BadgePiratesLLC/CactusCon13/BOM/CC13-MainBoard-BOM.csv

Reference | Qty | Value | Footprint | MPN | LCSC# | Manufacturer | DNP
BT1,BT2 | 2 | Battery | BadgePirates:Battery - 14500 | 53 |  | Keystone Electronics
BZ1 | 1 | Buzzer | BadgePirates:FUET-9032-Buzzer | FUET-9032 |  | Fuet Electronics
C2 | 1 | 1uF | BadgePirates:C_0805_2012Metric | CL21B105KBFNNNE | C28323 | Samsung Electro-Mechanics
C3,C5,C6,C8,C10 | 5 | 0.1uF | BadgePirates:C_0805_2012Metric | CT41G-0805-2X1-50V-0.1μF-K(N) | C126469 | TORCH
C4 | 1 | 22uF | BadgePirates:C_0805_2012Metric | CL21A226MAYNNNE | C602037 | Samsung Electro-Mechanics
C7 | 1 | 100uF | BadgePirates:100uf_CP_Pad1.50x2.35mm | TAJB107M006RNJ | C7195 | KYOCERA AVX
C9 | 1 | 10uF | BadgePirates:C_0805_2012Metric | CL21A106KPCLQNC | C962097 | Samsung Electro-Mechanics
D1 | 1 | PWR | BadgePirates:LED_1206 | NCD1206C1 | C84273 | Foshan NationStar Optoelectronics
D2 | 1 | Charging | BadgePirates:LED_1206 | NCD1206B1 | C130717 | Foshan NationStar Optoelectronics
D3-D8 | 6 | LED | BadgePirates:LED_Osram_Lx_P47F_D2mm_ReverseMount_Proper_Mask Only | AA3528SYCKT09 |  | KingBright
D9,D14,D15 | 3 | WS2812B | BadgePiratesFootprints:LED_WS2812B_PLCC4_5.0x5.0mm_P3.2mm | WS2812B-B/T | C2761795 | Worldsemi
D10-D13 | 4 | WS2812B | BadgePirates:LED_WS2812B_PLCC4_5.0x5.0mm_P3.2mm | WS2812B-B/T | C2761795 | Worldsemi
D19 | 1 | PESD2USB3UV-TR | BadgePirates:SOT-23 | PESD2USB3UV-TR | C7202955 | TECH PUBLIC
F1,F2 | 2 | Fuse | BadgePirates:R_1206_3216Metric | TLC-NSMD200 | C261957 | TLC Electronic
J2 | 1 | Micro_SD_Card | BadgePirates:TF_PUSH | TF PUSH | C393941 | SHOU HAN
J3 | 1 | ILI9341V | Connector_PinHeader_2.54mm:PinHeader_1x14_P2.54mm_Vertical |  |  |  | DNP
J8 | 1 | USB_C_Plug_USB2.0 | BadgePirates:USB_C_Receptical-Jing | 918-418K2023S40019 | C709035 | Jing Extension of the Electronic Co.
R1,R9,R10 | 3 | 1k | BadgePirates:R_1206_3216Metric | RC1206FR-071KL | C131398 | YAGEO
R2 | 1 | 2k | BadgePirates:R_1206_3216Metric | RC1206FR-072KL | C133543 | YAGEO
R3 | 1 | 330 | BadgePirates:R_1206_3216Metric | AC1206JR-07330KL | C229929 | YAGEO
R5 | 1 | 1M | BadgePirates:R_1206_3216Metric | RC1206FR-071ML | C108083 | YAGEO
R6 | 1 | 0 | BadgePirates:R_1206_3216Metric | 1206W4F0000T5E | C17888 | UNI-ROYAL(Uniroyal Elec)
R7,R8 | 2 | 5.1k | BadgePirates:R_1206_3216Metric | RC1206FR-075K1L | C163372 | YEGEO
R13 | 1 | 10K | BadgePirates:R_1206_3216Metric | RC1206FR-0710KL | C132649 | YAGEO
RN1,RN3 | 2 | 10k_Array | BadgePirates:R_Array_Convex_4x0603 | YC164-RR-0710KL | C110924 | YAGEO
RN2 | 1 | 1k_Array | BadgePirates:R_Array_Convex_4x0603 | YC164-JR-071KL | C93675 | YAGEO
SW1 | 1 | On/Off | BadgePirates:SW_SPDT_PCM12 | SSSS811101 | C109335 | ALPSALPINE
SW2 | 1 | Boot | BadgePirates:Switch_Tactile_SMD_B3U-1000P-BPVersion | B3U-1000P | C231329 | Omron Electronics
SW3 | 1 | Reset | BadgePirates:Switch_Tactile_SMD_B3U-1000P-BPVersion | B3U-1000P | C231329 | Omron Electronics
SW4 | 1 | SW_Enter | BadgePirates:SW_SPST_TL3305C(small)
SW5 | 1 | SW_Back | BadgePirates:SW_SPST_TL3305C(small)
SW6 | 1 | RotaryEncoder_Switch | BadgePirates:SIQ-02FVS3_Encoder
U1 | 1 | LTC4054 | BadgePirates:LTC4054 | TP4054ST25K | TP4054ST25K | TPOWER
U2 | 1 | ESP32-S3-WROOM-1 N16 | BadgePirates:ESP32-S3-WROOM-1 | ESP32-S3-WROOM-1-N8R8 | C2913200 | ESPRESSIF
U3 | 1 | CH340N | BadgePirates:SOIC-8-1EP_W3.9mm | CH340N | C2977777 | WCH(Jiangsu Qin Heng)
U4 | 1 | TLV1117LV33 | BadgePirates:SOT-223 | TLV1117LV33DCYR | C15578 | Texas Instruments
U5 | 1 | MAX17048 | BadgePirates:MAX17048_TDFN | MAX17048G+ | C2682616 | Analog Devices Inc
