BadgePiratesLLC/CactusCon13/3d_Prints/STLs/Full Plate of ScreenBezel_x10.3mf

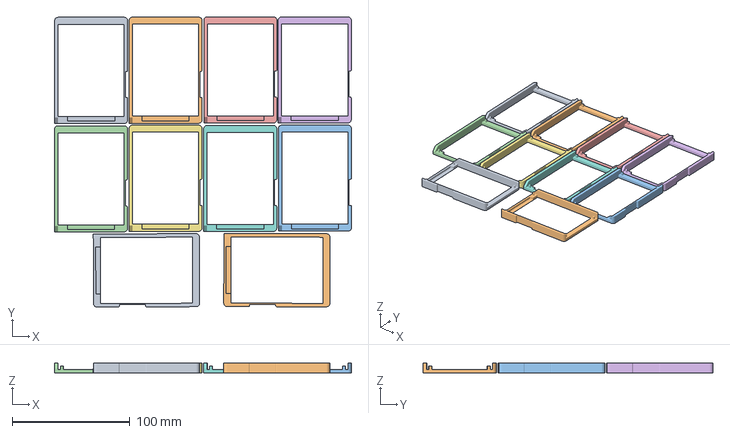
[picture p1: CAD file, 2025-03-16]
3d_Prints/STLs/Full Plate of ScreenBezel_x10.3mf
251.8 x 246.1 x 8.75 mm
ScreenProtector.stl x 10
