BadgePiratesLLC/CactusCon13/3d_Prints/STLs/Full Plate of BadgeStand-x18.3mf

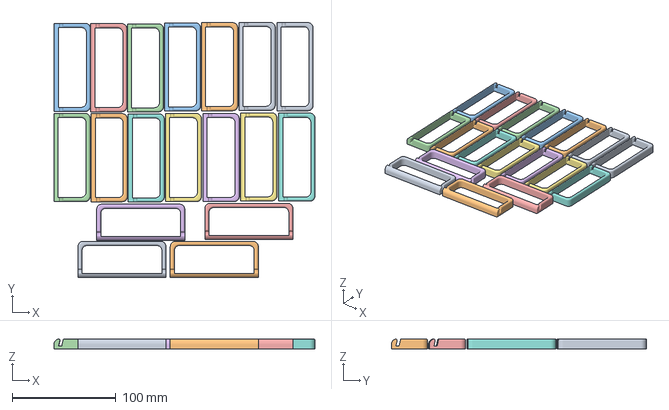
[picture p2: CAD file, 2025-03-16]
3d_Prints/STLs/Full Plate of BadgeStand-x18.3mf
251.8 x 246.4 x 10.0 mm
BadgeStand-v3.stl x 18
