BadgePiratesLLC/CactusCon13/3d_Prints/Models/BadgeStand v6.3mf

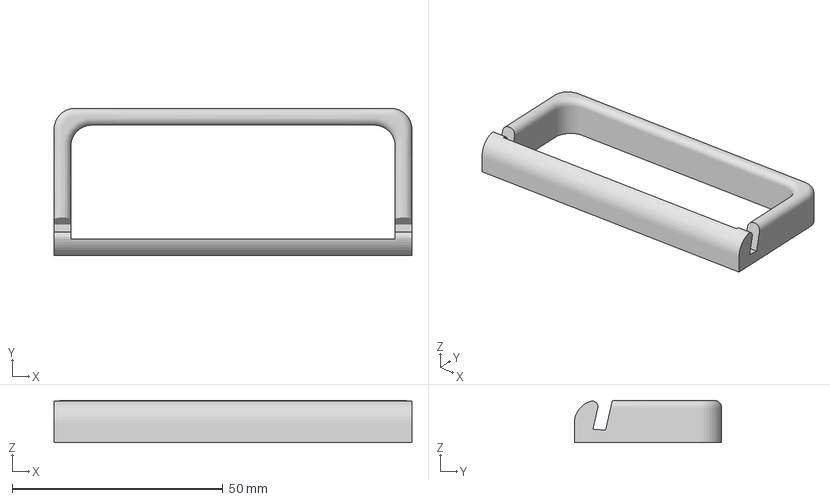
[picture p3: CAD file, 2025-03-16]
3d_Prints/Models/BadgeStand v6.3mf
85.0 x 35.0 x 10.0 mm
