BadgePiratesLLC/CactusCon13/CAD/Project-CC13.step

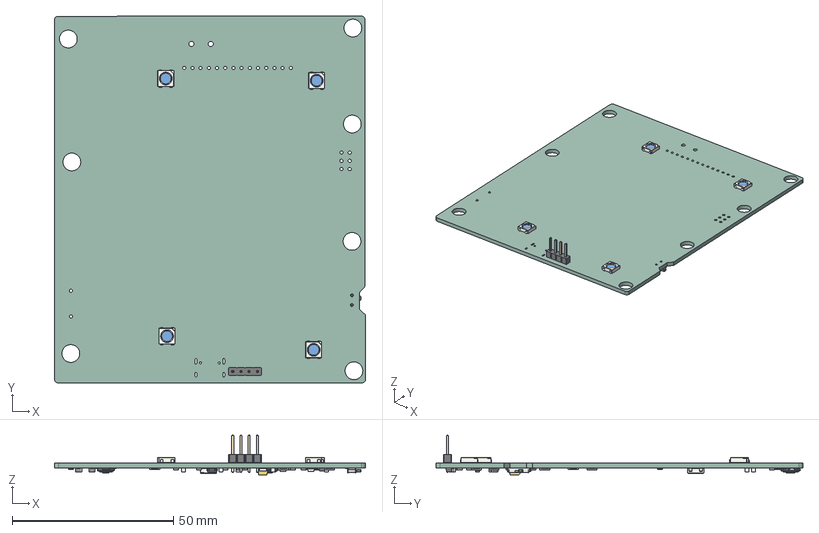
[picture p4: CAD file, 2025-03-16]
CAD/Project-CC13.step
96.5 x 113.7 x 12.3 mm
LED_WS2812B_PLCC4_50x50mm_P32mm x 5
PinHeader_1x04_P254mm_Vertical
LED_1206_3216Metric x 2
R_1206_3216Metric x 12
R_Array_Convex_4x0603 x 3
SOT_23
C_0805_2012Metric x 8
SW_SPST_TL3342 x 2
CP_EIA_3528_21_Kemet_B
Fusion_sp
DFN-8-1EP_2x2mm_Pitch0.5mm
Project-RTV_PCB
