BadgePiratesLLC/CactusCon13/3d_Prints/Models/ScreenBezel v5.3mf

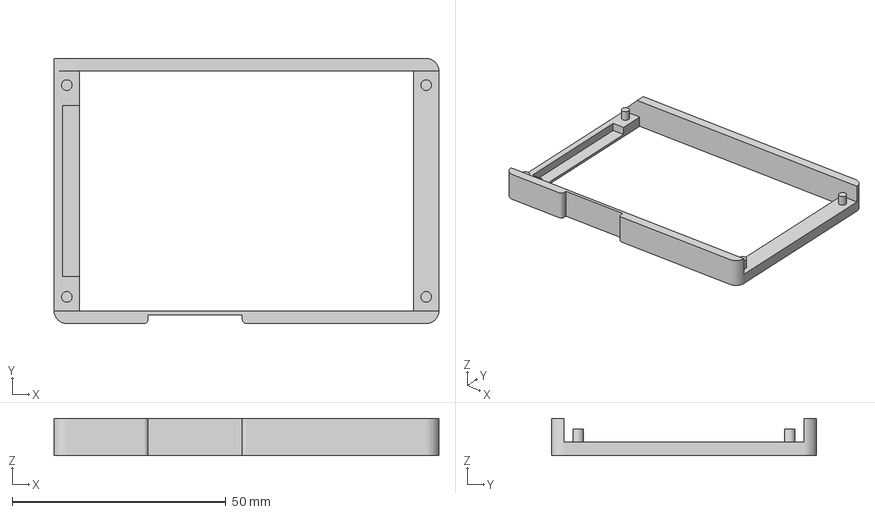
[picture p5: CAD file, 2025-03-16]
3d_Prints/Models/ScreenBezel v5.3mf
90.0 x 62.0 x 8.75 mm
