BadgePiratesLLC/CactusCon13/3d_Prints/STLs/Project-CC_SolderJig_All_x2.3mf

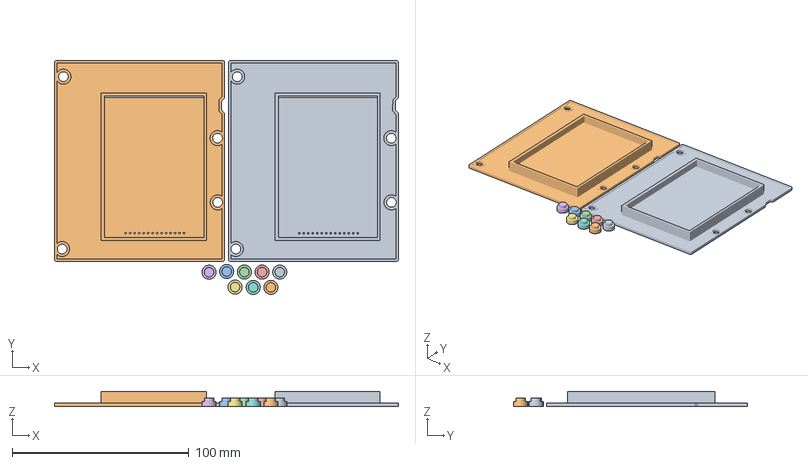
[picture p6: CAD file, 2025-03-16]
3d_Prints/STLs/Project-CC_SolderJig_All_x2.3mf
194.5 x 132.3 x 8.76 mm
Project-CC_SolderJigBody.stl x 2
Project-CC_SolderJig_Risers.stl x 8
