BadgePiratesLLC/CactusCon13/3d_Prints/STLs/Project-CC_SolderJigBody.stl

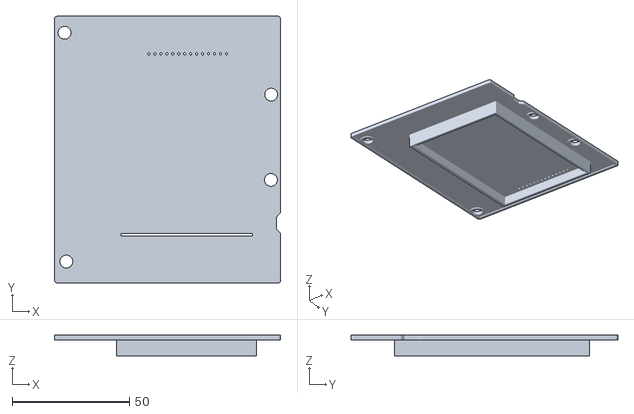
[picture p7: CAD file, 2025-03-16]
3d_Prints/STLs/Project-CC_SolderJigBody.stl
96.2 x 113.7 x 8.76
