BadgePiratesLLC/CactusCon13/3d_Prints/STLs/Project-CC_SolderJig_Risers.3mf

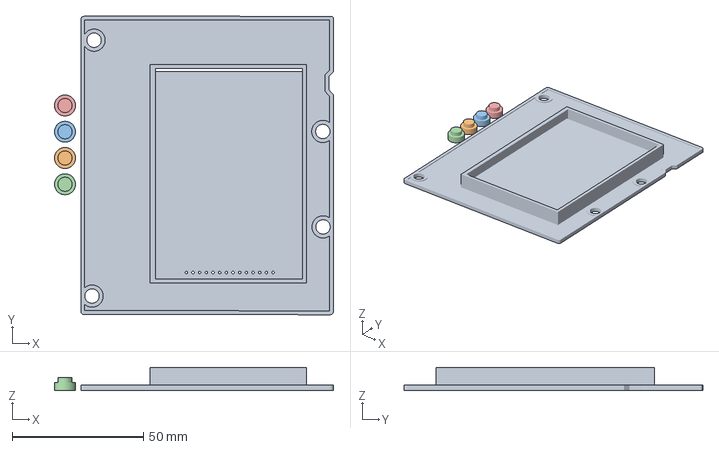
[picture p8: CAD file, 2025-03-16]
3d_Prints/STLs/Project-CC_SolderJig_Risers.3mf
106.2 x 113.7 x 8.76 mm
Project-CC_SolderJigBody.stl
Project-CC_SolderJig_Risers.stl x 4
