BadgePiratesLLC/CactusCon13/(list of files, cad)

Other CAD files:
3d_Prints/STLs/BadgeStand-v3.stl
3d_Prints/STLs/ScreenBezel-v3.stl
3d_Prints/Models/BadgeStand v6.f3d
3d_Prints/Models/ScreenBezel v5.f3d
3d_Prints/STLs/Project-CC_SolderJig&Risers.stl
