BadgePiratesLLC/CactusCon13/CAD/Project-CC13.kicad_pcb

## KiCad design CAD/Project-CC13.kicad_pcb (2025-03-16)

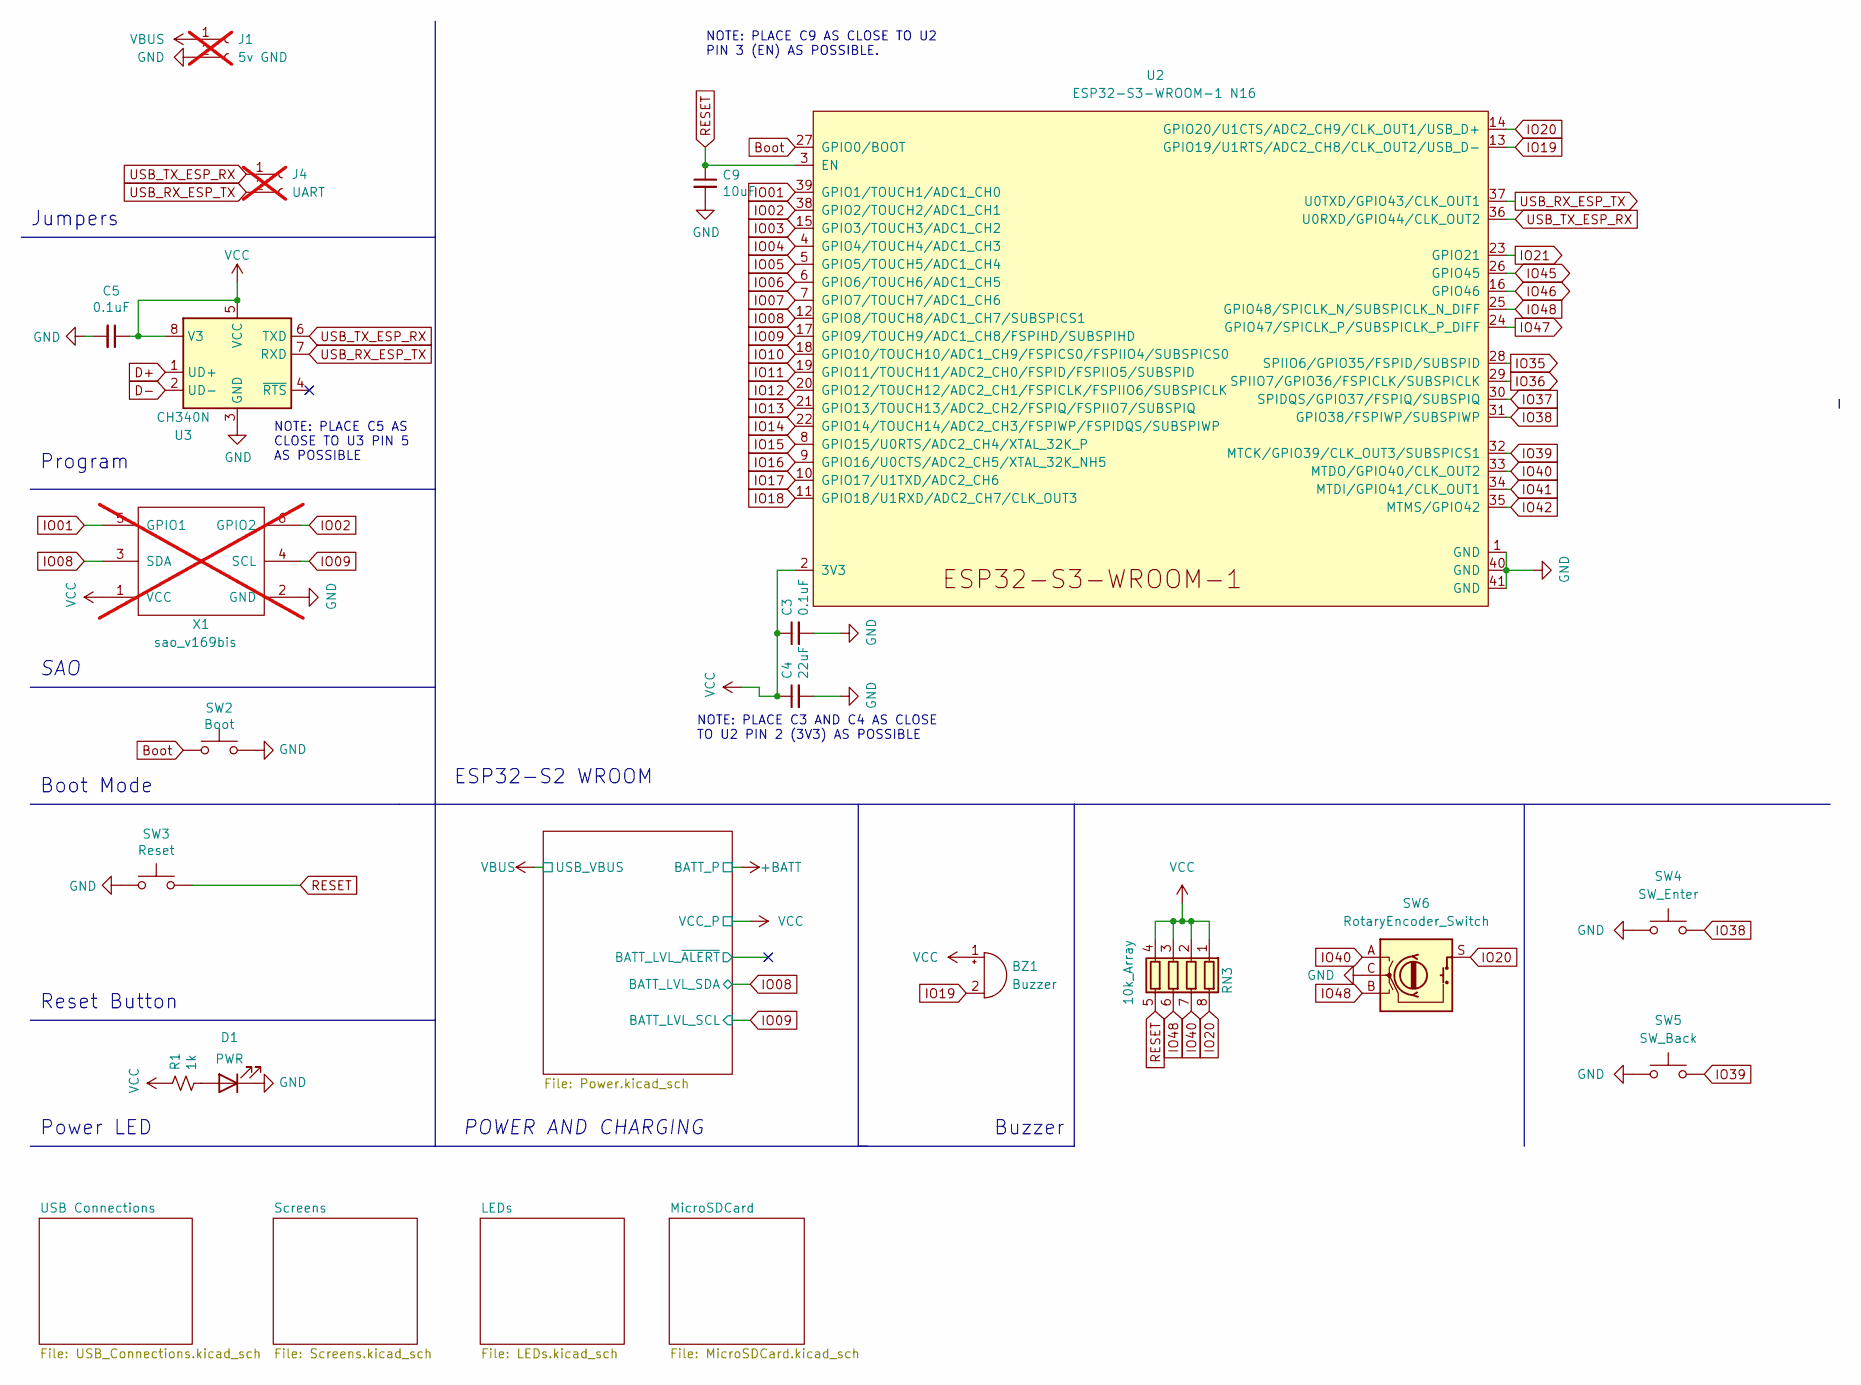
[picture p9: schematic Project-CC13.kicad_sch, CactusCon]

Parts:
BZ1: Buzzer; FUET-9032-Buzzer
C3, C5: 0.1uF; C_0805_2012Metric; MFG_PN CT41G-0805-2X1-50V-0.1μF-K(N)
C4: 22uF; C_0805_2012Metric; MFG_PN CL21A226MAYNNNE
C9: 10uF; C_0805_2012Metric; MFG_PN CL21A106KPCLQNC
D1: PWR; LED_1206; MFG_PN NCD1206C1
J1: 5v GND; PinHeader_1x02_P2.54mm_Vertical; not fitted
J4: UART; PinHeader_1x02_P2.54mm_Vertical; not fitted
R1: 1k; R_1206_3216Metric; MFG_PN RC1206FR-071KL
RN3: 10k_Array; R_Array_Convex_4x0603; MFG_PN YC164-RR-0710KL
SW2: Boot; Switch_Tactile_SMD_B3U-1000P-BPVersion; MFG_PN B3U-1000P
SW3: Reset; Switch_Tactile_SMD_B3U-1000P-BPVersion; MFG_PN B3U-1000P
SW4: SW_Enter; SW_SPST_TL3305C(small)
SW5: SW_Back; SW_SPST_TL3305C(small)
SW6: RotaryEncoder_Switch; SIQ-02FVS3_Encoder
U2: ESP32-S3-WROOM-1 N16; ESP32-S3-WROOM-1; MFG_PN ESP32-S3-WROOM-1-N8R8
U3: CH340N; SOIC-8-1EP_W3.9mm; MFG_PN CH340N
X1: sao_v169bis; Badgelife-SAOv169-SAO_Side_B.SLK; not fitted

Connections:
Boot: SW2.1, U2.27 (GPIO0/BOOT)
D+: U3.1 (UD+); also elsewhere on the board
D-: U3.2 (UD-); also elsewhere on the board
GND: C3.2, C4.2, C5.2, C9.2, D1.1 (K), J1.2, SW2.2, SW3.1, SW4.1, SW5.1, SW6.C, U2.1 (GND), U2.40 (GND), U2.41 (GND), U3.3 (GND), X1.2 (GND); also elsewhere on the board
IO01: U2.39 (GPIO1/TOUCH1/ADC1_CH0), X1.5 (GPIO1)
IO02: U2.38 (GPIO2/TOUCH2/ADC1_CH1), X1.6 (GPIO2)
IO03: U2.15 (GPIO3/TOUCH3/ADC1_CH2); also elsewhere on the board
IO04: U2.4 (GPIO4/TOUCH4/ADC1_CH3); also elsewhere on the board
IO05: U2.5 (GPIO5/TOUCH5/ADC1_CH4); also elsewhere on the board
IO06: U2.6 (GPIO6/TOUCH6/ADC1_CH5); also elsewhere on the board
IO07: U2.7 (GPIO7/TOUCH7/ADC1_CH6); also elsewhere on the board
IO08: U2.12 (GPIO8/TOUCH8/ADC1_CH7/SUBSPICS1), X1.3 (SDA); also elsewhere on the board
IO09: U2.17 (GPIO9/TOUCH9/ADC1_CH8/FSPIHD/SUBSPIHD), X1.4 (SCL); also elsewhere on the board
IO10: U2.18 (GPIO10/TOUCH10/ADC1_CH9/FSPICS0/FSPIIO4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); also elsewhere on the board
IO11: U2.19 (GPIO11/TOUCH11/ADC2_CH0/FSPID/FSPIIO5/S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); also elsewhere on the board
IO12: U2.20 (GPIO12/TOUCH12/ADC2_CH1/FSPICLK/FSPIIO6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); also elsewhere on the board
IO13: U2.21 (GPIO13/TOUCH13/ADC2_CH2/FSPIQ/FSPIIO7/S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); also elsewhere on the board
IO14: U2.22 (GPIO14/TOUCH14/ADC2_CH3/FSPIWP/FSPIDQS/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); also elsewhere on the board
IO15: U2.8 (GPIO15/U0RTS/ADC2_CH4/XTAL_32K_P); also elsewhere on the board
IO16: U2.9 (GPIO16/U0CTS/ADC2_CH5/XTAL_32K_NH5); also elsewhere on the board
IO17: U2.10 (GPIO17/U1TXD/ADC2_CH6); also elsewhere on the board
IO18: U2.11 (GPIO18/U1RXD/ADC2_CH7/CLK_OUT3); also elsewhere on the board
IO19: BZ1.2 (+), U2.13 (GPIO19/U1RTS/ADC2_CH8/CLK_OUT2/USB_D-)
IO20: RN3.8 (R1.2), SW6.S, U2.14 (GPIO20/U1CTS/ADC2_CH9/CLK_OUT1/USB_D+); also elsewhere on the board
IO21: U2.23 (GPIO21); also elsewhere on the board
IO35: U2.28 (SPIIO6/GPIO35/FSPID/SUBSPID); also elsewhere on the board
IO36: U2.29 (SPIIO7/GPIO36/FSPICLK/SUBSPICLK); also elsewhere on the board
IO37: U2.30 (SPIDQS/GPIO37/FSPIQ/SUBSPIQ); also elsewhere on the board
IO40: RN3.7 (R2.2), SW6.A, U2.33 (MTDO/GPIO40/CLK_OUT2); also elsewhere on the board
IO41: U2.34 (MTDI/GPIO41/CLK_OUT1)
IO42: U2.35 (MTMS/GPIO42)
IO45: U2.26 (GPIO45)
IO46: U2.16 (GPIO46); also elsewhere on the board
IO47: U2.24 (GPIO47/SPICLK_P/SUBSPICLK_P_DIFF); also elsewhere on the board
IO48: RN3.6 (R3.2), SW6.B, U2.25 (GPIO48/SPICLK_N/SUBSPICLK_N_DIFF); also elsewhere on the board
unnamed: D1.2 (A), R1.2
RESET: C9.1, RN3.5 (R4.2), SW3.2, U2.3 (EN)
USB_RX_ESP_TX: J4.2, U2.37 (U0TXD/GPIO43/CLK_OUT1), U3.7 (RXD)
USB_TX_ESP_RX: J4.1, U2.36 (U0RXD/GPIO44/CLK_OUT2), U3.6 (TXD)
VBUS: J1.1; also elsewhere on the board
VCC: BZ1.1 (-), C3.1, C4.1, C5.1, R1.1, RN3.1 (R1.1), RN3.2 (R2.1), RN3.3 (R3.1), RN3.4 (R4.1), U2.2 (3V3), U3.5 (VCC), U3.8 (V3), X1.1 (VCC); also elsewhere on the board

Notes on the sheet:
Buzzer
POWER AND CHARGING
SAO
Power LED
Jumpers
ESP32-S2 WROOM
NOTE: PLACE C5 AS CLOSE TO U3 PIN 5 AS POSSIBLE
Program
Boot Mode
NOTE: PLACE C3 AND C4 AS CLOSE TO U2 PIN 2 (3V3) AS POSSIBLE
Reset Button
NOTE: PLACE C9 AS CLOSE TO U2 PIN 3 (EN) AS POSSIBLE.

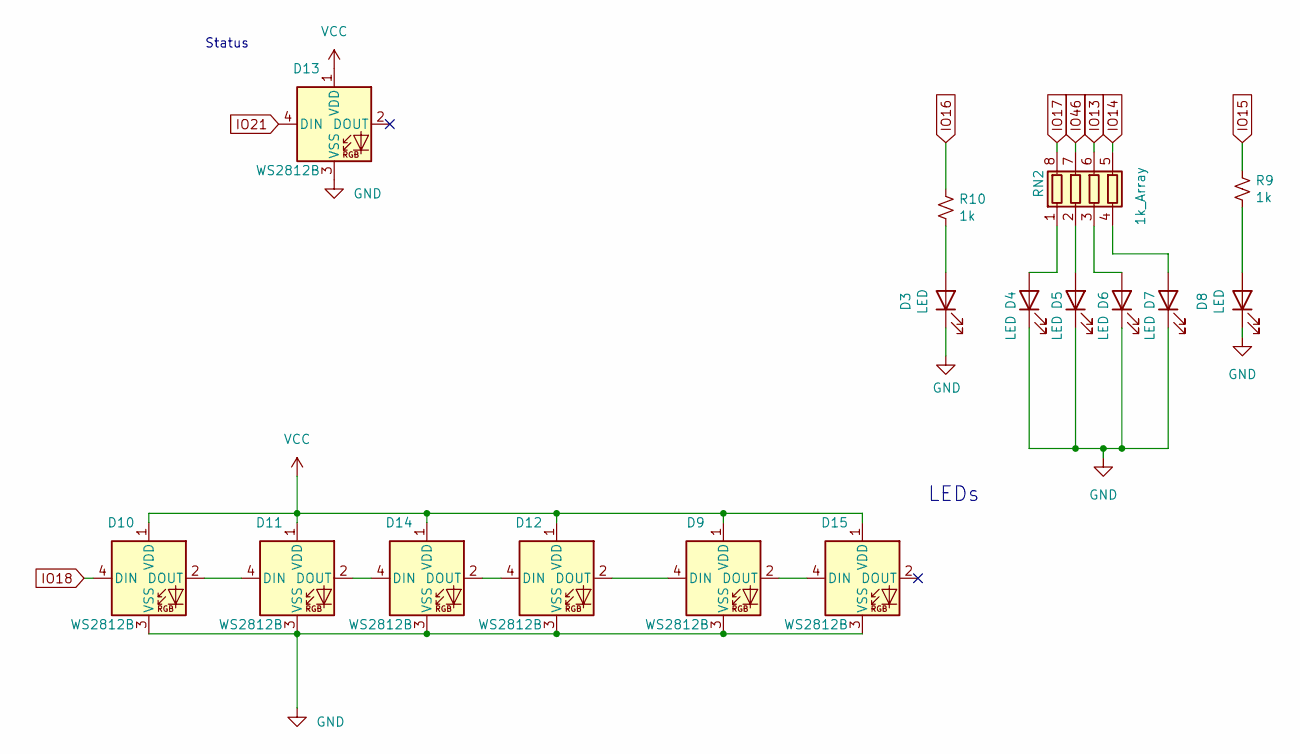
[picture p10: schematic LEDs.kicad_sch, RedTeamVillage]

Parts:
D3, D4, D5, D6, D7, D8: LED; LED_Osram_Lx_P47F_D2mm_ReverseMount_Proper_Mask Only; MFG_PN AA3528SYCKT09
D9, D10, D11, D12, D13, D14, D15: WS2812B; LED_WS2812B_PLCC4_5.0x5.0mm_P3.2mm; MFG_PN WS2812B-B/T
R9, R10: 1k; R_1206_3216Metric; MFG_PN RC1206FR-071KL
RN2: 1k_Array; R_Array_Convex_4x0603; MFG_PN YC164-JR-071KL

Connections:
GND: D3.1 (K), D4.1 (K), D5.1 (K), D6.1 (K), D7.1 (K), D8.1 (K), D9.3 (VSS), D10.3 (VSS), D11.3 (VSS), D12.3 (VSS), D13.3 (VSS), D14.3 (VSS), D15.3 (VSS); also elsewhere on the board
IO13: RN2.6 (R3.2); also elsewhere on the board
IO14: RN2.5 (R4.2); also elsewhere on the board
IO15: R9.1; also elsewhere on the board
IO16: R10.1; also elsewhere on the board
IO17: RN2.8 (R1.2); also elsewhere on the board
IO18: D10.4 (DIN); also elsewhere on the board
IO21: D13.4 (DIN); also elsewhere on the board
IO46: RN2.7 (R2.2); also elsewhere on the board
unnamed: D3.2 (A), R10.2
unnamed: D4.2 (A), RN2.1 (R1.1)
unnamed: D5.2 (A), RN2.2 (R2.1)
unnamed: D6.2 (A), RN2.3 (R3.1)
unnamed: D7.2 (A), RN2.4 (R4.1)
unnamed: D8.2 (A), R9.2
unnamed: D10.2 (DOUT), D11.4 (DIN)
unnamed: D11.2 (DOUT), D14.4 (DIN)
unnamed: D12.4 (DIN), D14.2 (DOUT)
unnamed: D9.4 (DIN), D12.2 (DOUT)
unnamed: D9.2 (DOUT), D15.4 (DIN)
VCC: D9.1 (VDD), D10.1 (VDD), D11.1 (VDD), D12.1 (VDD), D13.1 (VDD), D14.1 (VDD), D15.1 (VDD); also elsewhere on the board

Notes on the sheet:
LEDs
Status

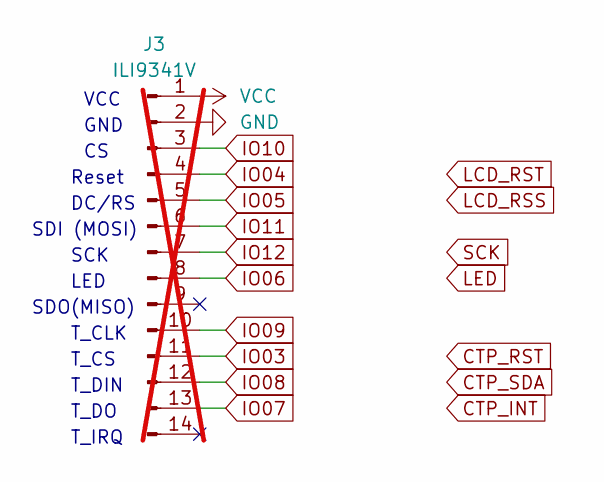
[picture p11: schematic Screens.kicad_sch, RedTeamVillage]

Parts:
J3: ILI9341V; PinHeader_1x14_P2.54mm_Vertical; not fitted

Connections:
GND: J3.2; also elsewhere on the board
IO03: J3.11; also elsewhere on the board
IO04: J3.4; also elsewhere on the board
IO05: J3.5; also elsewhere on the board
IO06: J3.8; also elsewhere on the board
IO07: J3.13; also elsewhere on the board
IO08: J3.12; also elsewhere on the board
IO09: J3.10; also elsewhere on the board
IO10: J3.3; also elsewhere on the board
IO11: J3.6; also elsewhere on the board
IO12: J3.7; also elsewhere on the board
VCC: J3.1; also elsewhere on the board

Notes on the sheet:
Reset
SDO(MISO)
SCK
T_CLK
SDI (MOSI)
LED
T_IRQ
T_DO
GND
T_CS
DC/RS
T_DIN
VCC

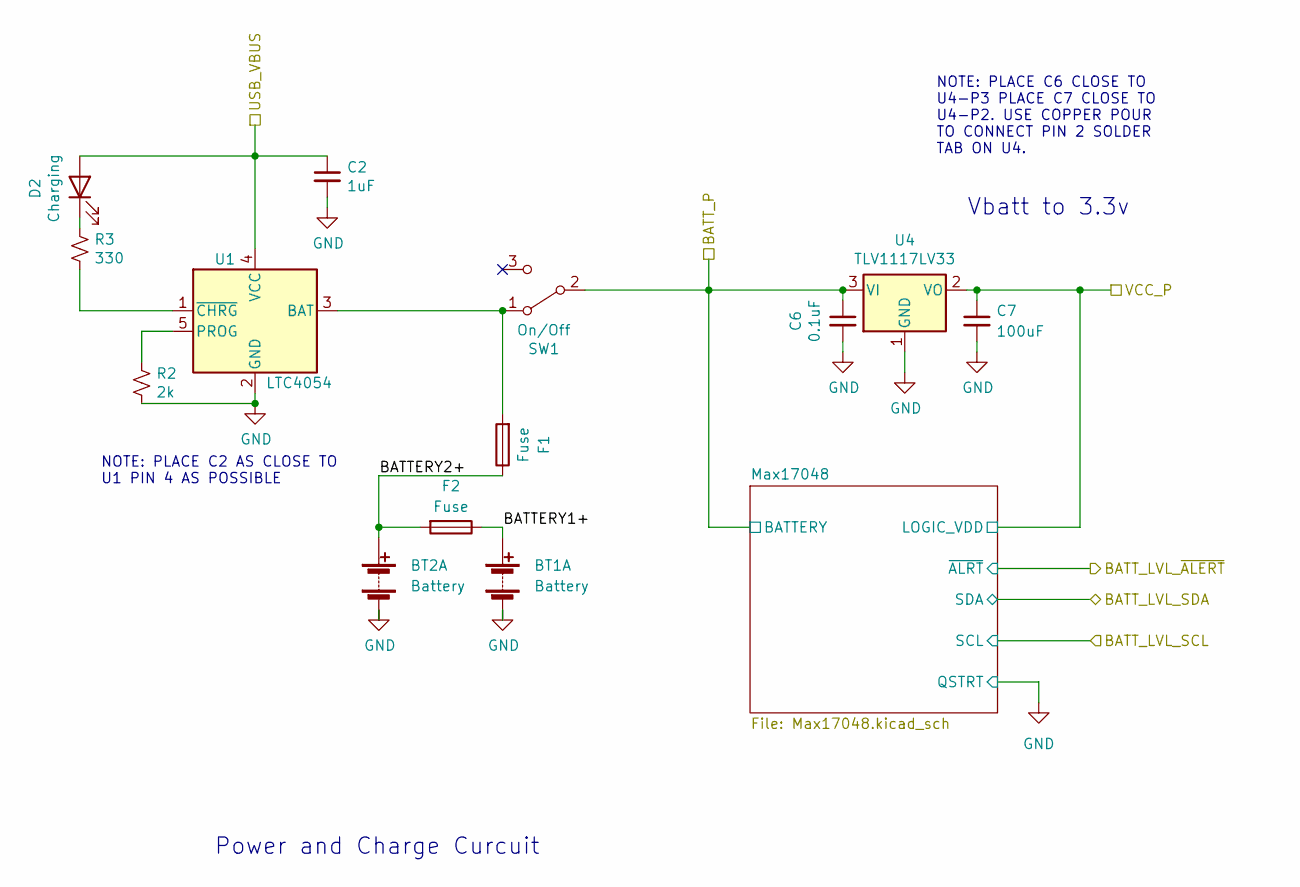
[picture p12: schematic Power.kicad_sch, RedTeamVillage]

Parts:
BT1, BT2: Battery; Battery - 14500; MFG_PN 53
C2: 1uF; C_0805_2012Metric; MFG_PN CL21B105KBFNNNE
C6: 0.1uF; C_0805_2012Metric; MFG_PN CT41G-0805-2X1-50V-0.1μF-K(N)
C7: 100uF; 100uf_CP_Pad1.50x2.35mm; MFG_PN TAJB107M006RNJ
D2: Charging; LED_1206; MFG_PN NCD1206B1
F1, F2: Fuse; R_1206_3216Metric; MFG_PN TLC-NSMD200
R2: 2k; R_1206_3216Metric; MFG_PN RC1206FR-072KL
R3: 330; R_1206_3216Metric; MFG_PN AC1206JR-07330KL
SW1: On/Off; SW_SPDT_PCM12; MFG_PN SSSS811101
U1: LTC4054; MFG_PN TP4054ST25K
U4: TLV1117LV33; SOT-223; MFG_PN TLV1117LV33DCYR

Connections:
+BATT: C6.1, SW1.2 (B), U4.3 (VI); also elsewhere on the board
/Power and Charge Curcuit/BATTERY1+: BT1.1 (+), F2.1
/Power and Charge Curcuit/BATTERY2+: BT2.1 (+), F1.1, F2.2
GND: BT1.2 (-), BT2.2 (-), C2.2, C6.2, C7.2, R2.2, U1.2 (GND), U4.1 (GND); also elsewhere on the board
unnamed: D2.1 (K), R3.1
unnamed: F1.2, SW1.1 (A), U1.3 (BAT)
unnamed: R2.1, U1.5 (PROG)
unnamed: R3.2, U1.1 (~CHRG)
VBUS: C2.1, D2.2 (A), U1.4 (VCC); also elsewhere on the board
VCC: C7.1, U4.2 (VO), U4.4 (VO); also elsewhere on the board

Notes on the sheet:
Power and Charge Curcuit
NOTE: PLACE C2 AS CLOSE TO U1 PIN 4 AS POSSIBLE
NOTE: PLACE C6 CLOSE TO U4-P3 PLACE C7 CLOSE TO U4-P2. USE COPPER POUR TO CONNECT PIN 2 SOLDER TAB ON U4.
Vbatt to 3.3v

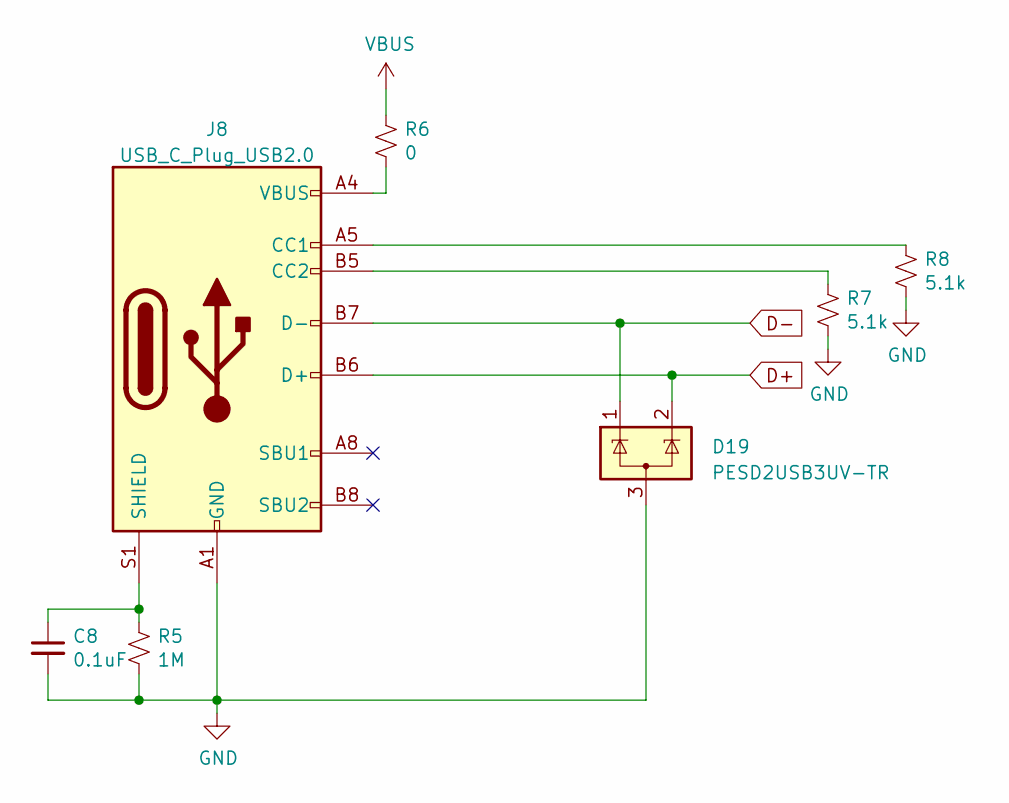
[picture p13: schematic USB_Connections.kicad_sch, RedTeamVillage]

Parts:
C8: 0.1uF; C_0805_2012Metric; MFG_PN CT41G-0805-2X1-50V-0.1μF-K(N)
D19: PESD2USB3UV-TR; SOT-23; MFG_PN PESD2USB3UV-TR
J8: USB_C_Plug_USB2.0; USB_C_Receptical-Jing; MFG_PN 918-418K2023S40019
R5: 1M; R_1206_3216Metric; MFG_PN RC1206FR-071ML
R6: 0; R_1206_3216Metric; MFG_PN 1206W4F0000T5E
R7, R8: 5.1k; R_1206_3216Metric; MFG_PN RC1206FR-075K1L

Connections:
D+: D19.2 (K), J8.A6 (D+), J8.B6 (D+); also elsewhere on the board
D-: D19.1 (K), J8.A7 (D-), J8.B7 (D-); also elsewhere on the board
GND: C8.2, D19.3 (A), J8.A1 (GND), J8.A12 (GND), J8.B1 (GND), J8.B12 (GND), R5.2, R7.2, R8.2; also elsewhere on the board
unnamed: J8.A5 (CC1), R8.1
unnamed: J8.B5 (CC2), R7.1
unnamed: C8.1, J8.S1 (SHIELD), R5.1
unnamed: J8.A4 (VBUS), J8.A9 (VBUS), J8.B4 (VBUS), J8.B9 (VBUS), R6.2
VBUS: R6.1; also elsewhere on the board

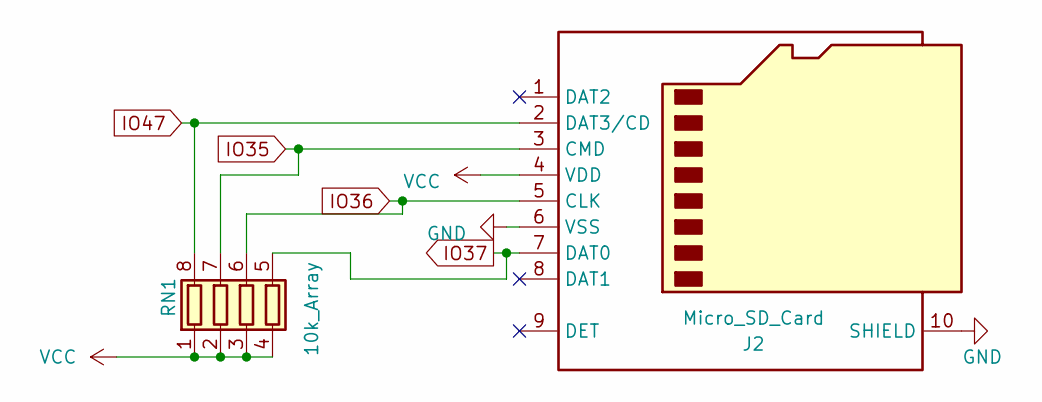
[picture p14: schematic MicroSDCard.kicad_sch]

Parts:
J2: Micro_SD_Card; TF_PUSH; MFG_PN TF PUSH
RN1: 10k_Array; R_Array_Convex_4x0603; MFG_PN YC164-RR-0710KL

Connections:
GND: J2.6 (VSS), J2.10 (SHIELD); also elsewhere on the board
IO35: J2.3 (CMD), RN1.7 (R2.2); also elsewhere on the board
IO36: J2.5 (CLK), RN1.6 (R3.2); also elsewhere on the board
IO37: J2.7 (DAT0), RN1.5 (R4.2); also elsewhere on the board
IO47: J2.2 (DAT3/CD), RN1.8 (R1.2); also elsewhere on the board
VCC: J2.4 (VDD), RN1.1 (R1.1), RN1.2 (R2.1), RN1.3 (R3.1), RN1.4 (R4.1); also elsewhere on the board

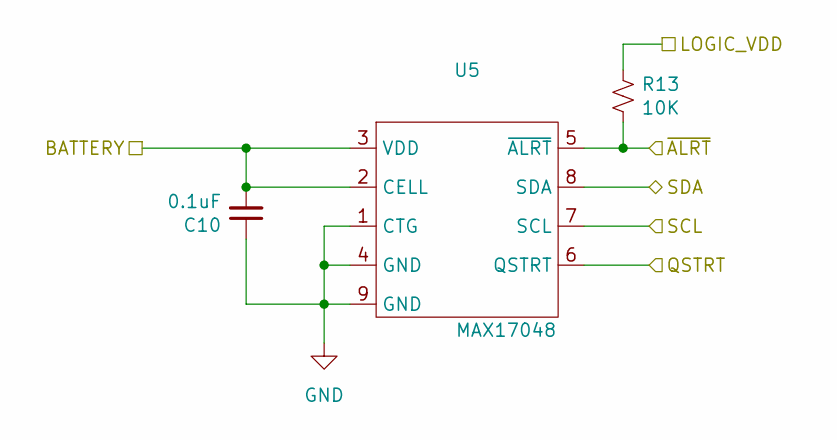
[picture p15: schematic Max17048.kicad_sch, RedTeamVillage]

Parts:
C10: 0.1uF; C_0805_2012Metric; MFG_PN CT41G-0805-2X1-50V-0.1μF-K(N)
R13: 10K; R_1206_3216Metric; MFG_PN RC1206FR-0710KL
U5: MAX17048; MAX17048_TDFN; MFG_PN MAX17048G+

Connections:
+BATT: C10.2, U5.2 (CELL), U5.3 (VDD); also elsewhere on the board
/Power and Charge Curcuit/BATT_LVL_~ALERT: R13.2, U5.5 (~ALRT)
GND: C10.1, U5.1 (CTG), U5.4 (GND), U5.6 (QSTRT), U5.9 (GND); also elsewhere on the board
IO08: U5.8 (SDA); also elsewhere on the board
IO09: U5.7 (SCL); also elsewhere on the board
VCC: R13.1; also elsewhere on the board

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
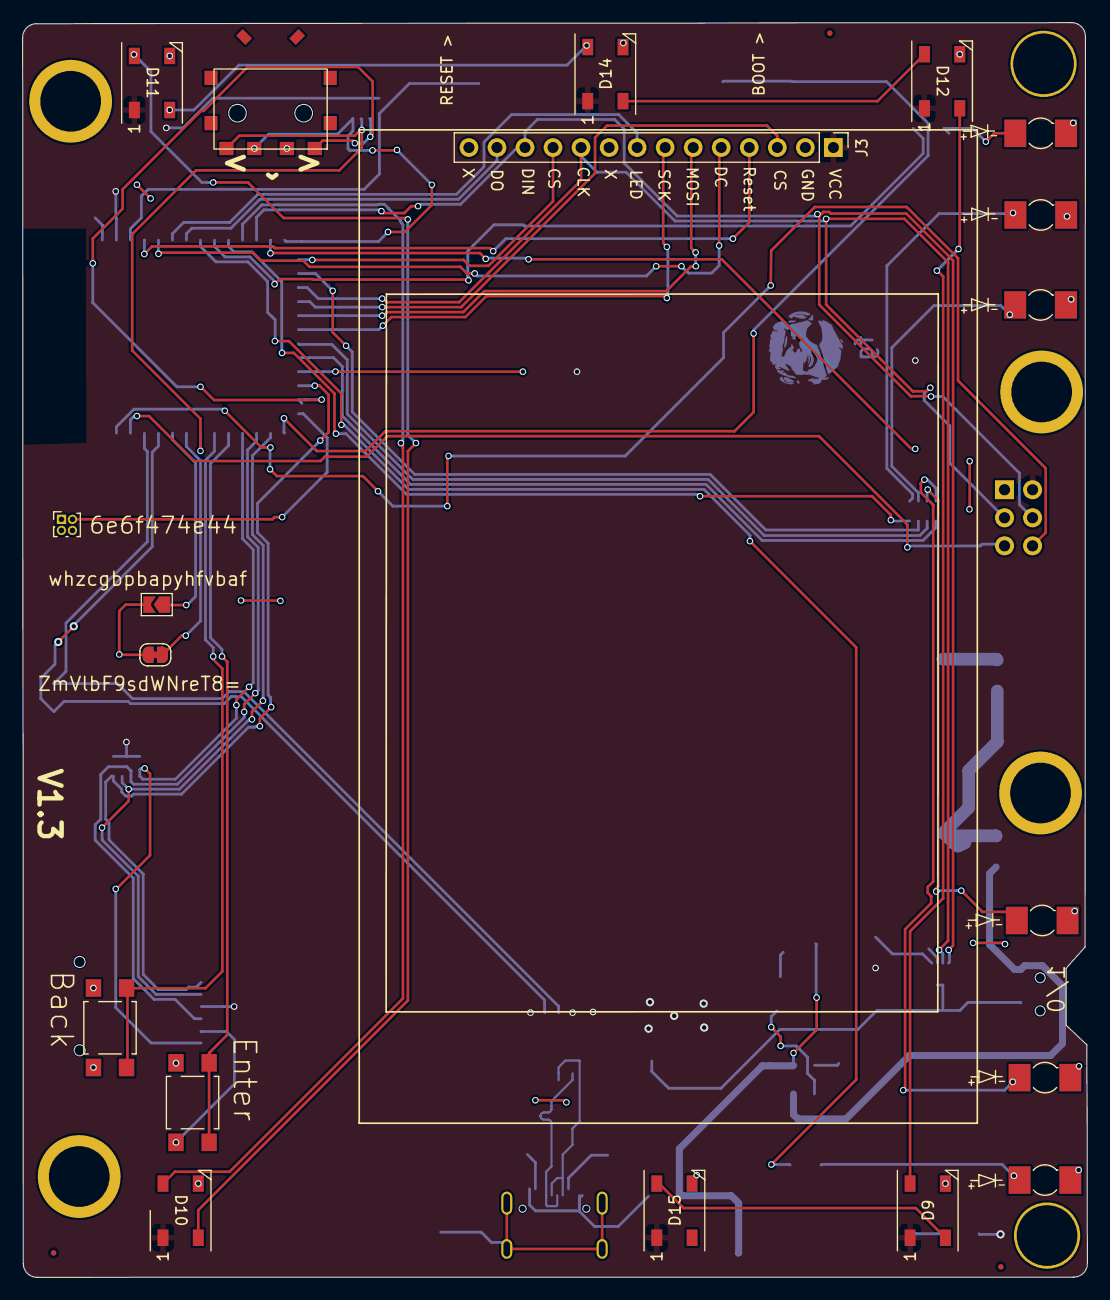
[picture p16: board Project-CC13.kicad_pcb from above]

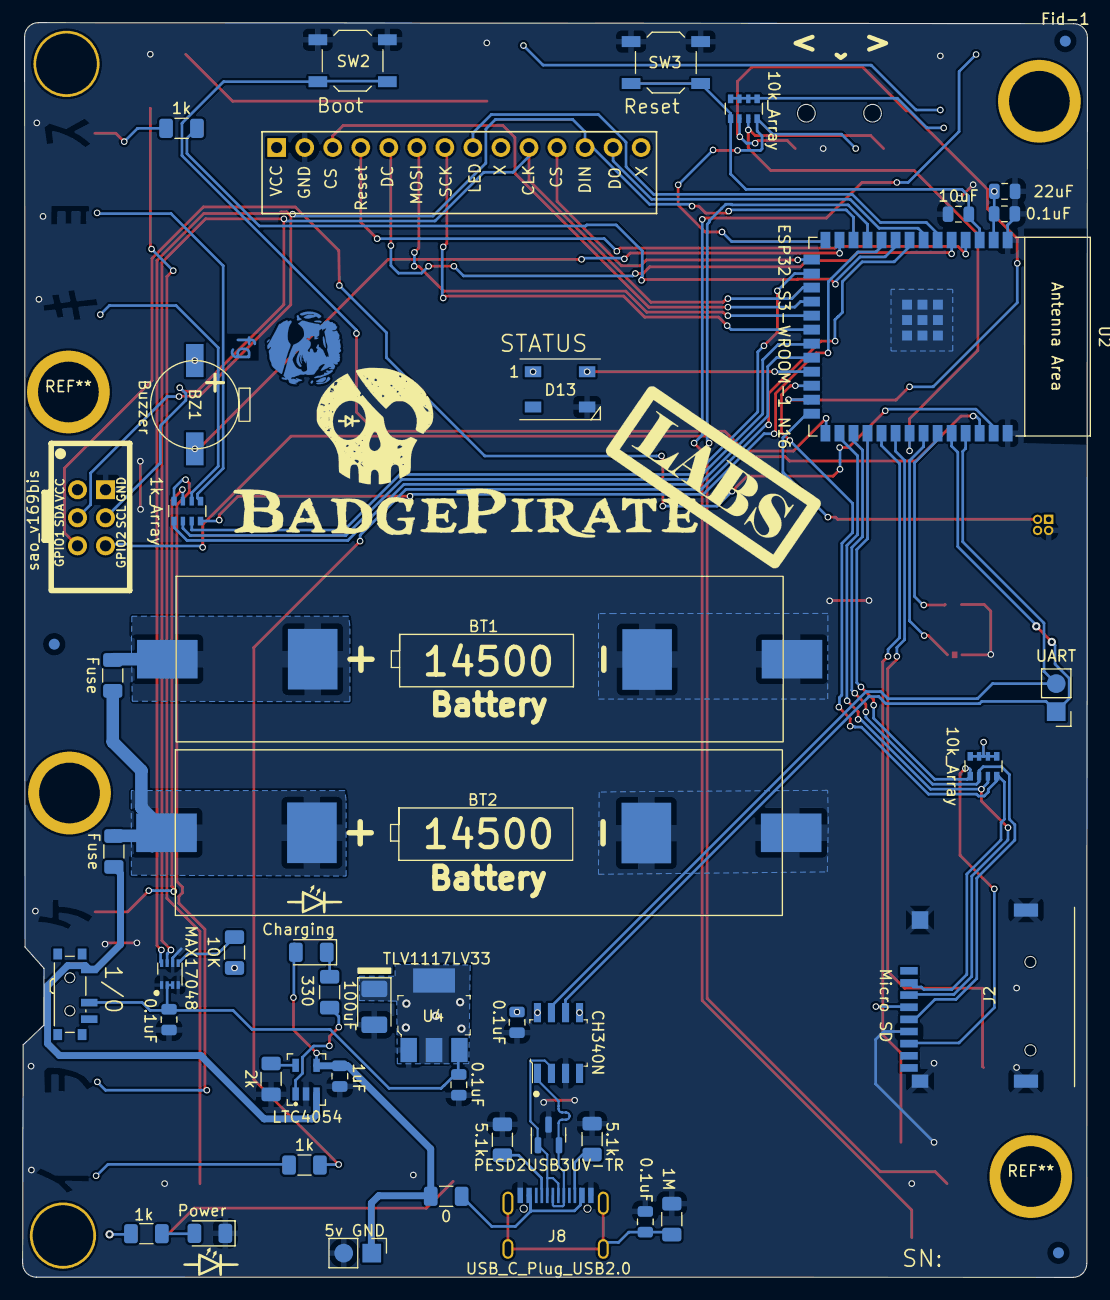
[picture p17: board Project-CC13.kicad_pcb from below]

Board: 2 copper layers, 96.5 x 113.7 mm, 67 parts (47 on the bottom side), 63 nets.

Other parts of the board:
Fid-1, Fid-2, Fid-3: Fiducial_1mm_Mask2mm
Fid-4, Fid-5, Fid-6: Fiducial_0.5mm_Mask1mm
Ref**: Val**; BadgePiratesLabs
SW8: SW_Center; SW_SPST_TL3305C(small)
SW10: RotaryEncoder_Switch; SIQ-02FVS3_Encoder

Their connections:
GND: SW8.1, SW10.C; also elsewhere on the board
IO20: SW10.S; also elsewhere on the board
IO40: SW10.A; also elsewhere on the board
IO48: SW10.B; also elsewhere on the board
